Tyler3D/Big-Brane-AoE/Code/README.md

Arduino code stored in folder named "audio" to make sure INO files are concatenated in correct order (so that `main.ino` is imported last).
