Tyler3D/Big-Brane-AoE/Circuit/2020-12-13 - schematic.pdf

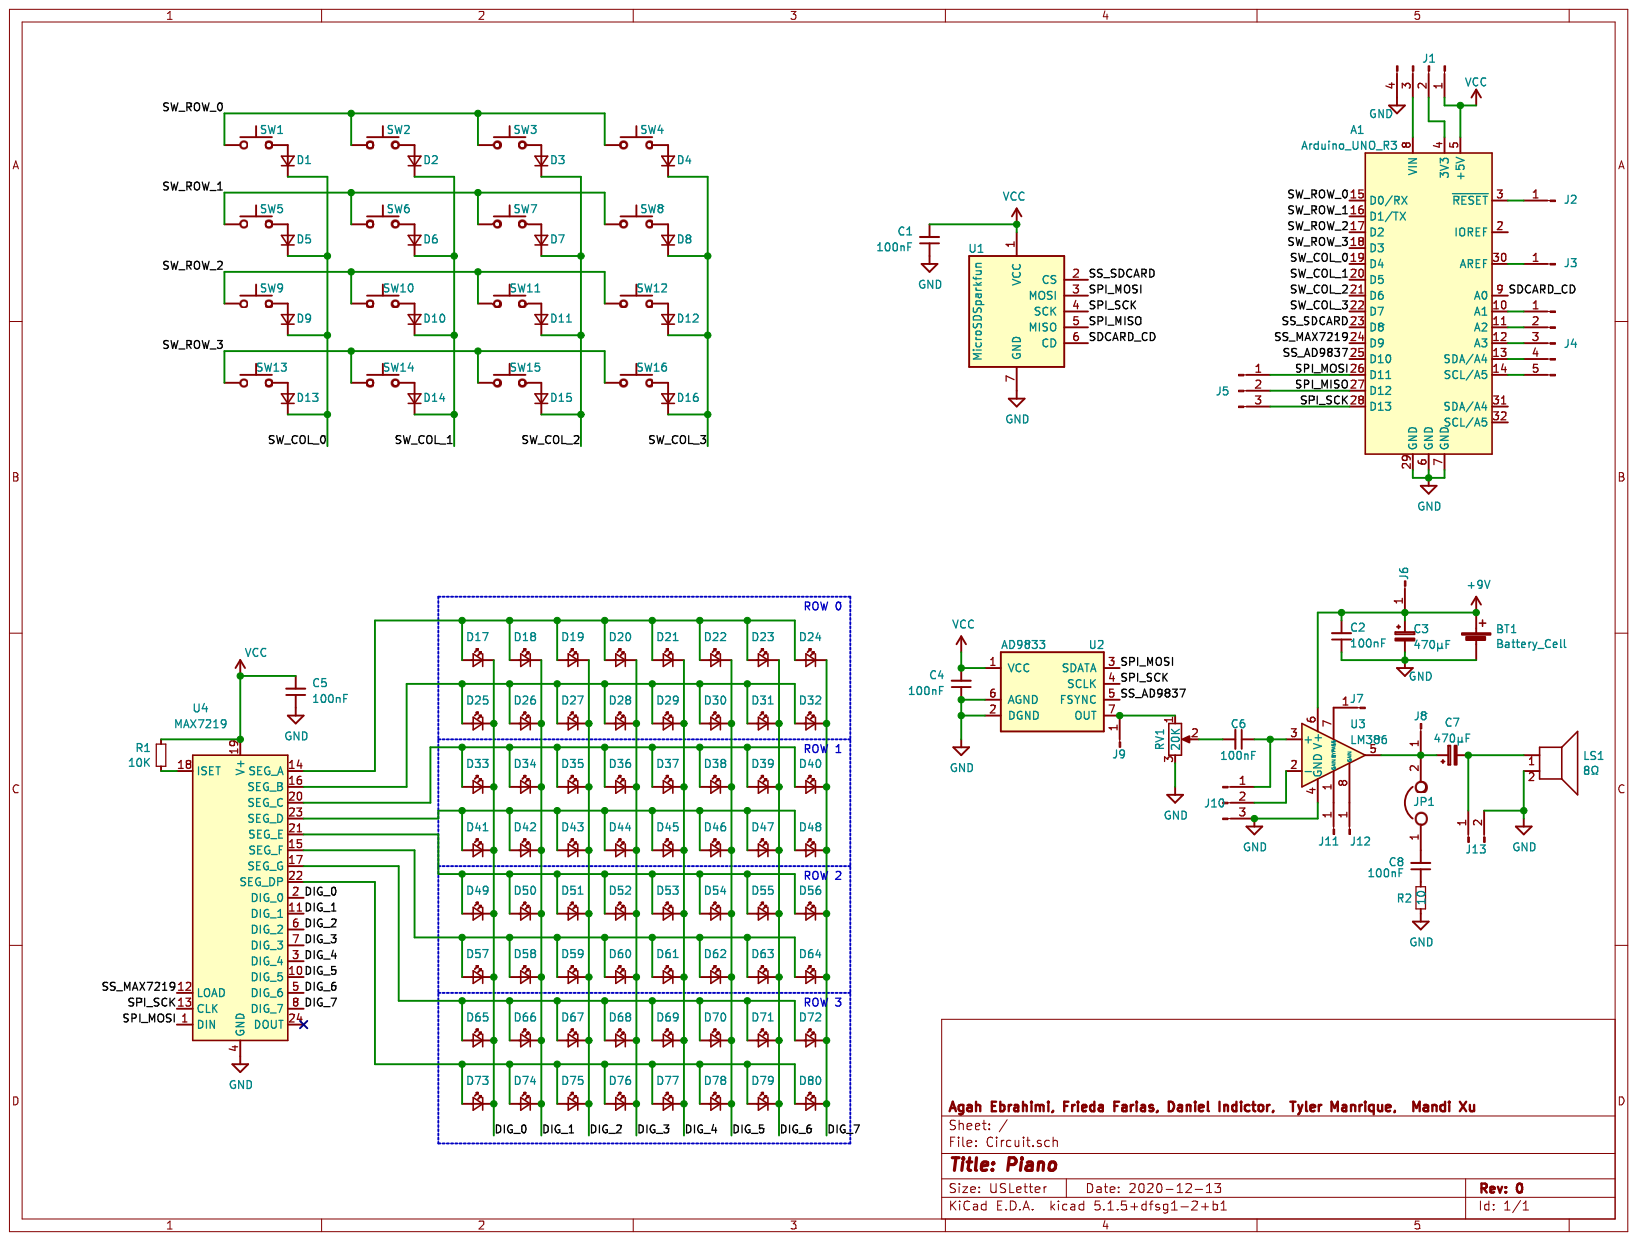
[picture p1: page 1]
