Tyler3D/Big-Brane-AoE/Circuit/Circuit.kicad_pcb

## KiCad design Circuit/Circuit.kicad_pcb (2020-12-20)

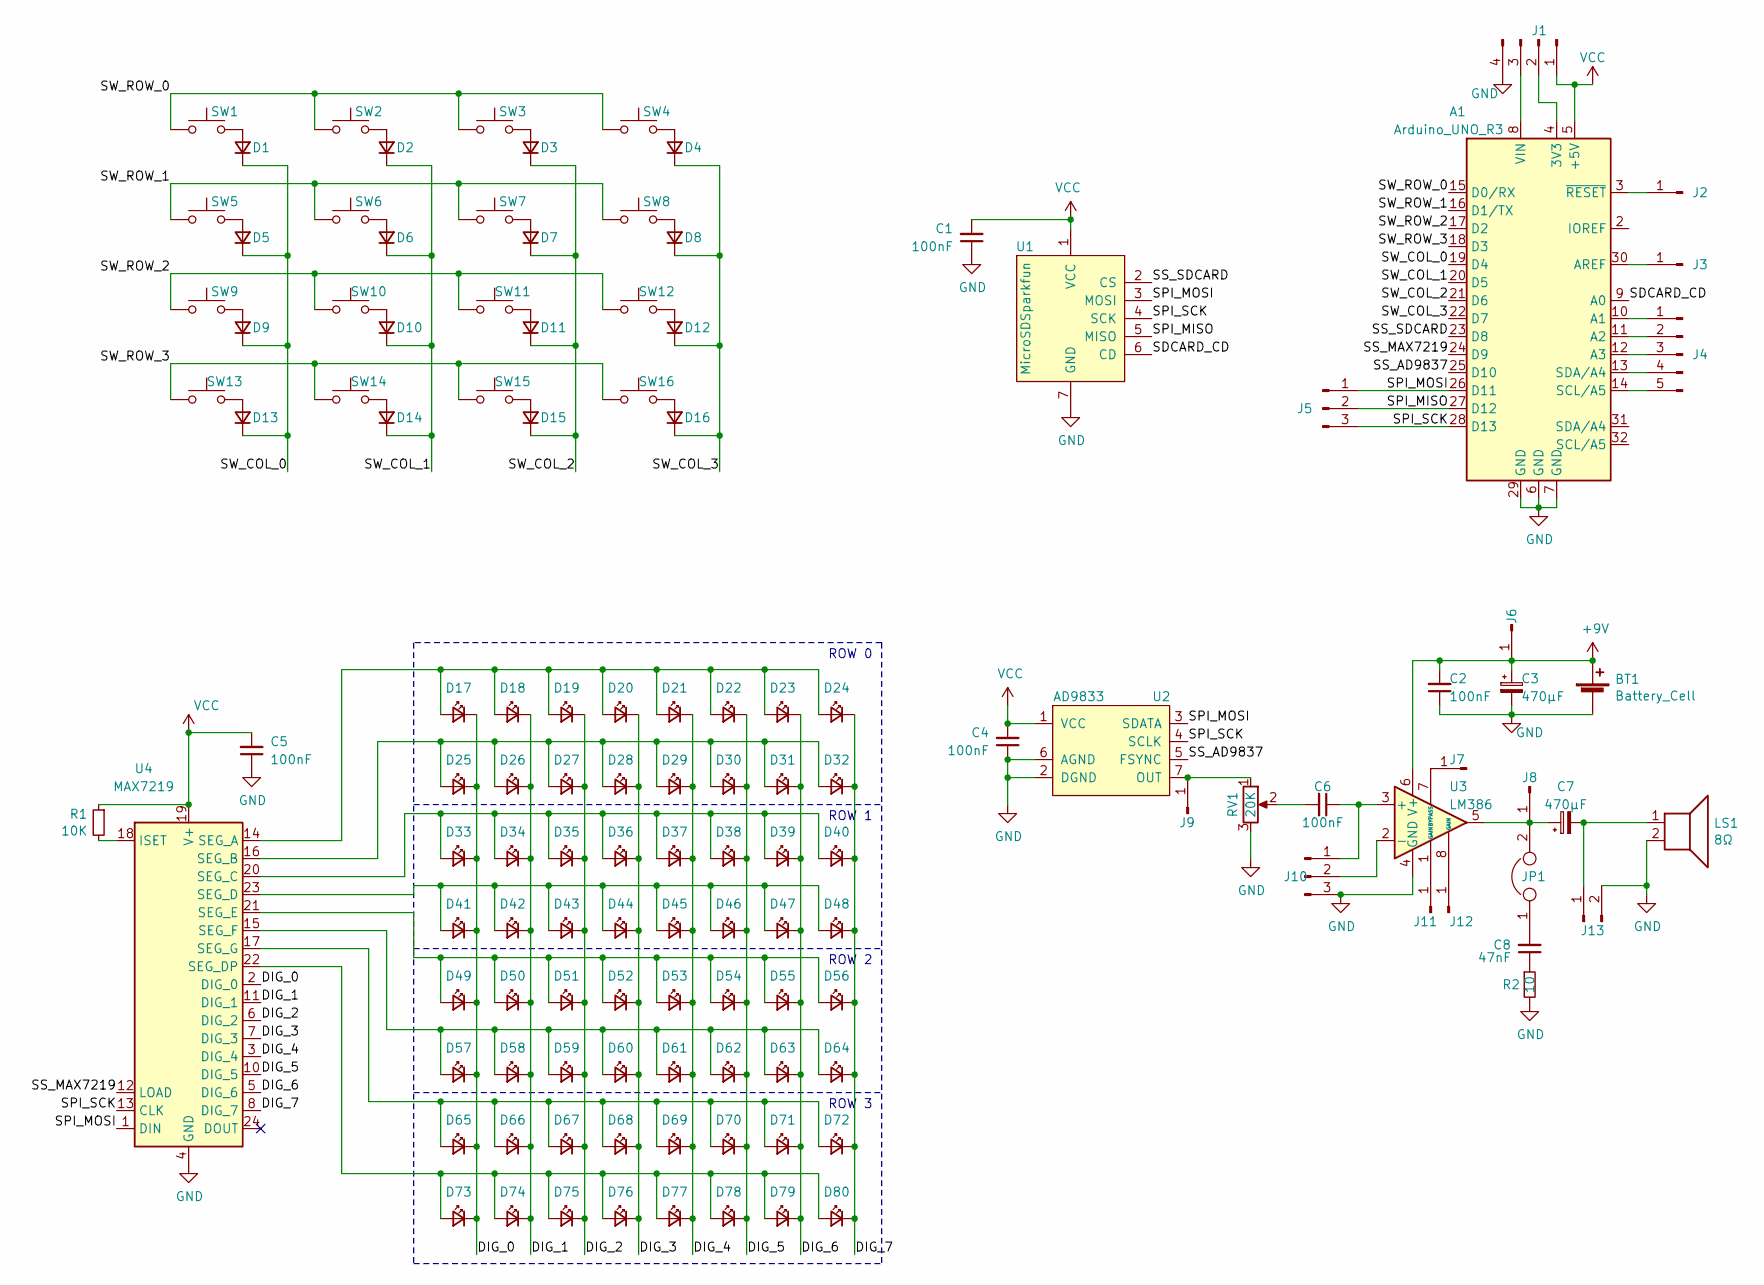
[picture p2: schematic Circuit.sch, Piano]

Parts:
A1: Arduino_UNO_R3
BT1: Battery_Cell; JST_EH_B2B-EH-A_1x02_P2.50mm_Vertical
C1, C2, C4, C5, C6: 100nF; C_Disc_D4.3mm_W1.9mm_P5.00mm
C3, C7: 470μF; CP_Radial_D14.0mm_P7.50mm
C8: 47nF; C_Disc_D4.3mm_W1.9mm_P5.00mm
D1, D2, D3, D4, D5, D6, D7, D8, D9, D10, D11, D12, D13, D14, D15, D16: D_Small; D_SMB_Handsoldering
D17, D18, D19, D20, D21, D22, D23, D24, D25, D26, D27, D28, D29, D30, D31, D32, D33, D34, D35, D36, D37, D38, D39, D40, D41, D42, D43, D44, D45, D46, D47, D48, D49, D50, D51, D52, D53, D54, D55, D56, D57, D58, D59, D60, D61, D62, D63, D64, D65, D66, D67, D68, D69, D70, D71, D72, D73, D74, D75, D76, D77, D78, D79, D80: LED_Small; LED_D3.0mm_FlatTop
J1: POWER; PinHeader_1x04_P2.54mm_Vertical
J2: RESET; PinHeader_1x01_P2.54mm_Vertical
J3: AREF; PinHeader_1x01_P2.54mm_Vertical
J4: Analog Breakout; PinHeader_1x05_P2.54mm_Vertical
J5: SPI (MOSI, MISO, SCK); PinHeader_1x03_P2.54mm_Vertical
J6: LM386 VCC; PinHeader_1x01_P2.54mm_Vertical
J7: BYPASS; PinHeader_1x01_P2.54mm_Vertical
J8: LM386 OUT; PinHeader_1x01_P2.54mm_Vertical
J9: AD9833 OUT; PinHeader_1x01_P2.54mm_Vertical
J10: LM386 IN; PinHeader_1x03_P2.54mm_Vertical
J11: GAIN 1; PinHeader_1x01_P2.54mm_Vertical
J12: GAIN 8; PinHeader_1x01_P2.54mm_Vertical
J13: SPKR; PinHeader_1x02_P2.54mm_Vertical
JP1: Jumper; PinHeader_1x02_P2.54mm_Vertical
LS1: 8Ω; JST_EH_B2B-EH-A_1x02_P2.50mm_Vertical
R1: 10K; R_Axial_DIN0207_L6.3mm_D2.5mm_P7.62mm_Horizontal
R2: 10; R_Axial_DIN0207_L6.3mm_D2.5mm_P7.62mm_Horizontal
RV1: 20K; Potentiometer_Vishay_148-149_Single_Horizontal
SW1, SW2, SW3, SW4, SW5, SW6, SW7, SW8, SW9, SW10, SW11, SW12, SW13, SW14, SW15, SW16: SW_Push; SW_Cherry_MX_1.00u_PCB
U1: MicroSDSparkfun; PinHeader_1x07_P2.54mm_Horizontal
U2: AD9833; PinHeader_1x07_P2.54mm_Vertical
U3: LM386; DIP-8_W7.62mm_Socket_LongPads
U4: MAX7219; DIP-24_W7.62mm_LongPads

Connections:
+9V: BT1.1 (+), C2.2, C3.1, J6.1, U3.6 (V+)
/DIG_0: D17.1 (K), D25.1 (K), D33.1 (K), D41.1 (K), D49.1 (K), D57.1 (K), D65.1 (K), D73.1 (K), U4.2 (DIG_0)
/DIG_1: D18.1 (K), D26.1 (K), D34.1 (K), D42.1 (K), D50.1 (K), D58.1 (K), D66.1 (K), D74.1 (K), U4.11 (DIG_1)
/DIG_2: D19.1 (K), D27.1 (K), D35.1 (K), D43.1 (K), D51.1 (K), D59.1 (K), D67.1 (K), D75.1 (K), U4.6 (DIG_2)
/DIG_3: D20.1 (K), D28.1 (K), D36.1 (K), D44.1 (K), D52.1 (K), D60.1 (K), D68.1 (K), D76.1 (K), U4.7 (DIG_3)
/DIG_4: D21.1 (K), D29.1 (K), D37.1 (K), D45.1 (K), D53.1 (K), D61.1 (K), D69.1 (K), D77.1 (K), U4.3 (DIG_4)
/DIG_5: D22.1 (K), D30.1 (K), D38.1 (K), D46.1 (K), D54.1 (K), D62.1 (K), D70.1 (K), D78.1 (K), U4.10 (DIG_5)
/DIG_6: D23.1 (K), D31.1 (K), D39.1 (K), D47.1 (K), D55.1 (K), D63.1 (K), D71.1 (K), D79.1 (K), U4.5 (DIG_6)
/DIG_7: D24.1 (K), D32.1 (K), D40.1 (K), D48.1 (K), D56.1 (K), D64.1 (K), D72.1 (K), D80.1 (K), U4.8 (DIG_7)
/SDCARD_CD: A1.9 (A0), U1.6 (CD)
/SPI_MISO: A1.27 (D12), J5.2, U1.5 (MISO)
/SPI_MOSI: A1.26 (D11), J5.1, U1.3 (MOSI), U2.3 (SDATA), U4.1 (DIN)
/SPI_SCK: A1.28 (D13), J5.3, U1.4 (SCK), U2.4 (SCLK), U4.13 (CLK)
/SS_AD9837: A1.25 (D10), U2.5 (FSYNC)
/SS_MAX7219: A1.24 (D9), U4.12 (LOAD)
/SS_SDCARD: A1.23 (D8), U1.2 (CS)
/SW_COL_0: A1.19 (D4), D1.1 (K), D5.1 (K), D9.1 (K), D13.1 (K)
/SW_COL_1: A1.20 (D5), D2.1 (K), D6.1 (K), D10.1 (K), D14.1 (K)
/SW_COL_2: A1.21 (D6), D3.1 (K), D7.1 (K), D11.1 (K), D15.1 (K)
/SW_COL_3: A1.22 (D7), D4.1 (K), D8.1 (K), D12.1 (K), D16.1 (K)
/SW_ROW_0: A1.15 (D0/RX), SW1.2, SW2.2, SW3.2, SW4.2
/SW_ROW_1: A1.16 (D1/TX), SW5.2, SW6.2, SW7.2, SW8.2
/SW_ROW_2: A1.17 (D2), SW9.2, SW10.2, SW11.2, SW12.2
/SW_ROW_3: A1.18 (D3), SW13.2, SW14.2, SW15.2, SW16.2
GND: A1.6 (GND), A1.7 (GND), A1.29 (GND), BT1.2 (-), C1.1, C2.1, C3.2, C4.1, C5.1, J1.4, J10.3, J13.2, LS1.2, R2.2, RV1.3, U1.7 (GND), U2.2 (DGND), U2.6 (AGND), U3.4 (GND), U4.4 (GND), U4.9 (GND)
unnamed: A1.3 (~RESET), J2.1
unnamed: A1.4 (3V3), J1.2
unnamed: A1.8 (VIN), J1.3
unnamed: A1.10 (A1), J4.1
unnamed: A1.11 (A2), J4.2
unnamed: A1.12 (A3), J4.3
unnamed: A1.13 (SDA/A4), J4.4
unnamed: A1.14 (SCL/A5), J4.5
unnamed: A1.30 (AREF), J3.1
unnamed: C6.1, J10.1, U3.3 (+)
unnamed: C6.2, RV1.2
unnamed: C7.1, J8.1, JP1.2, U3.5
unnamed: C7.2, J13.1, LS1.1
unnamed: C8.1, R2.1
unnamed: C8.2, JP1.1
unnamed: D1.2 (A), SW1.1
unnamed: D2.2 (A), SW2.1
unnamed: D3.2 (A), SW3.1
unnamed: D4.2 (A), SW4.1
unnamed: D5.2 (A), SW5.1
unnamed: D6.2 (A), SW6.1
unnamed: D7.2 (A), SW7.1
unnamed: D8.2 (A), SW8.1
unnamed: D9.2 (A), SW9.1
unnamed: D10.2 (A), SW10.1
unnamed: D11.2 (A), SW11.1
unnamed: D12.2 (A), SW12.1
unnamed: D13.2 (A), SW13.1
unnamed: D14.2 (A), SW14.1
unnamed: D15.2 (A), SW15.1
unnamed: D16.2 (A), SW16.1
unnamed: D17.2 (A), D18.2 (A), D19.2 (A), D20.2 (A), D21.2 (A), D22.2 (A), D23.2 (A), D24.2 (A), U4.14 (SEG_A)
unnamed: D25.2 (A), D26.2 (A), D27.2 (A), D28.2 (A), D29.2 (A), D30.2 (A), D31.2 (A), D32.2 (A), U4.16 (SEG_B)
unnamed: D33.2 (A), D34.2 (A), D35.2 (A), D36.2 (A), D37.2 (A), D38.2 (A), D39.2 (A), D40.2 (A), U4.20 (SEG_C)
unnamed: D41.2 (A), D42.2 (A), D43.2 (A), D44.2 (A), D45.2 (A), D46.2 (A), D47.2 (A), D48.2 (A), U4.23 (SEG_D)
unnamed: D49.2 (A), D50.2 (A), D51.2 (A), D52.2 (A), D53.2 (A), D54.2 (A), D55.2 (A), D56.2 (A), U4.21 (SEG_E)
unnamed: D57.2 (A), D58.2 (A), D59.2 (A), D60.2 (A), D61.2 (A), D62.2 (A), D63.2 (A), D64.2 (A), U4.15 (SEG_F)
unnamed: D65.2 (A), D66.2 (A), D67.2 (A), D68.2 (A), D69.2 (A), D70.2 (A), D71.2 (A), D72.2 (A), U4.17 (SEG_G)
unnamed: D73.2 (A), D74.2 (A), D75.2 (A), D76.2 (A), D77.2 (A), D78.2 (A), D79.2 (A), D80.2 (A), U4.22 (SEG_DP)
unnamed: J7.1, U3.7 (BYPASS)
unnamed: J9.1, RV1.1, U2.7 (OUT)
unnamed: J10.2, U3.2 (-)
unnamed: J11.1, U3.1 (GAIN)
unnamed: J12.1, U3.8 (GAIN)
unnamed: R1.2, U4.18 (ISET)
VCC: A1.5 (+5V), C1.2, C4.2, C5.2, J1.1, R1.1, U1.1 (VCC), U2.1 (VCC), U4.19 (V+)

Notes on the sheet:
ROW 0
ROW 1
ROW 2
ROW 3

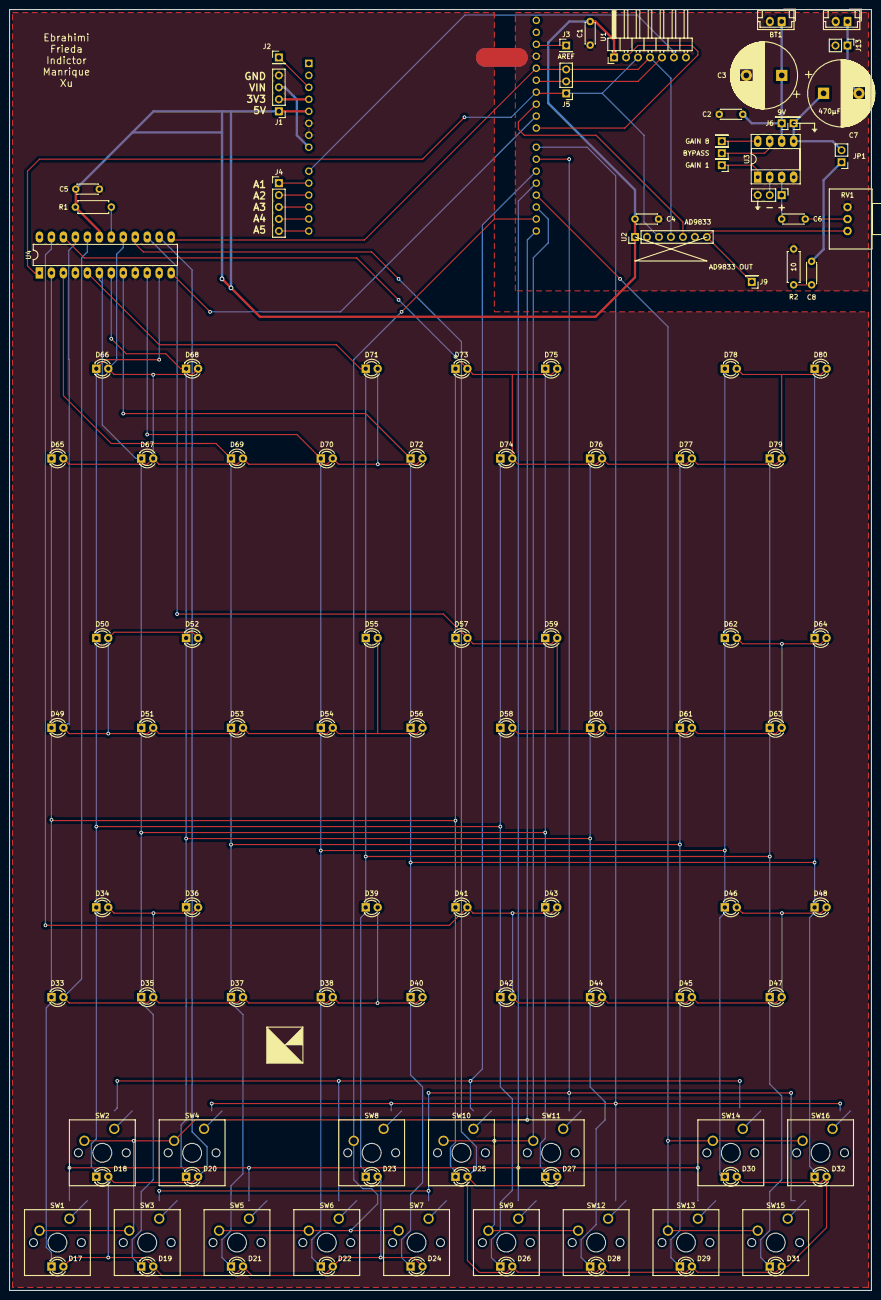
[picture p3: board Circuit.kicad_pcb from above]

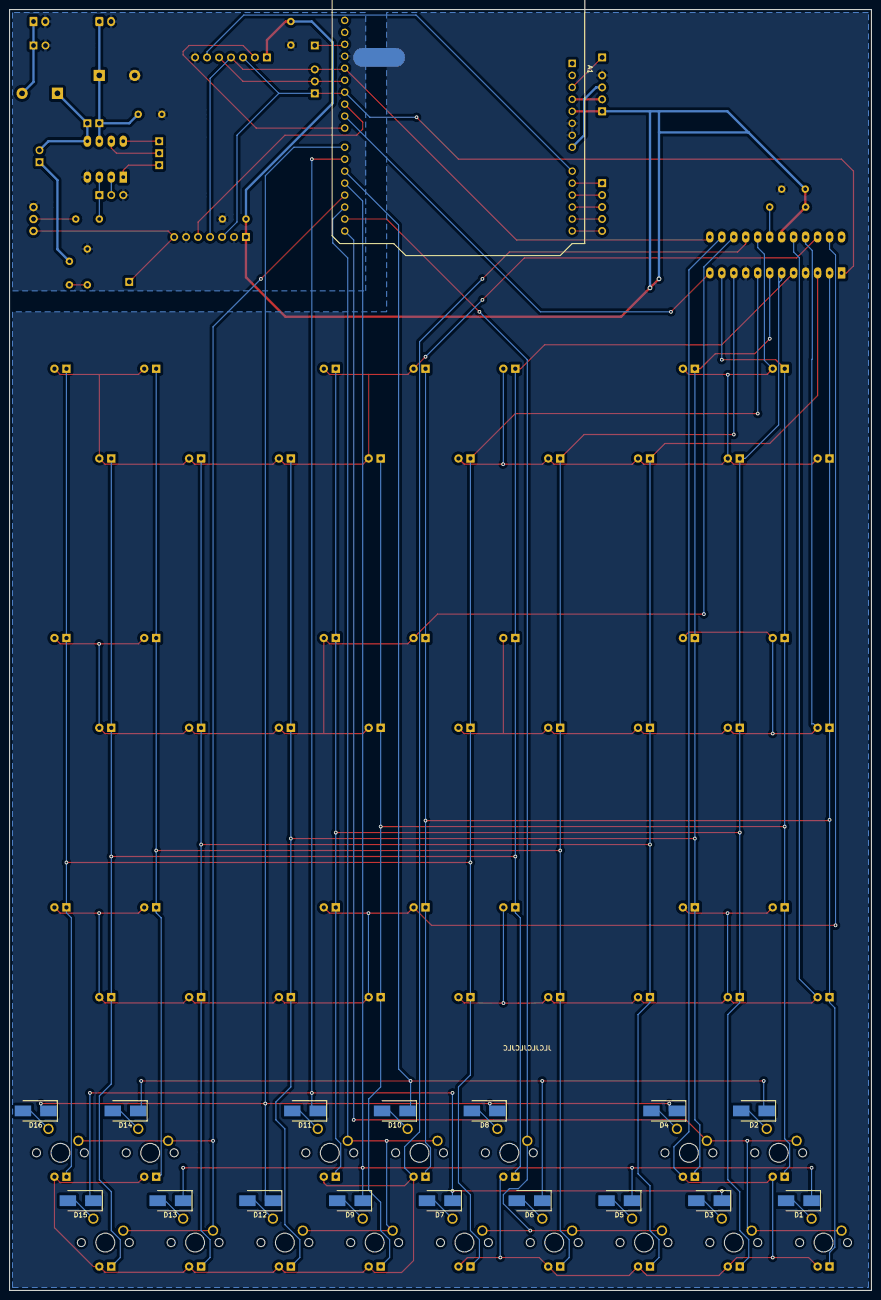
[picture p4: board Circuit.kicad_pcb from below]

Board: 2 copper layers, 182.9 x 271.8 mm, 128 parts (17 on the bottom side), 71 nets.
