Tyler3D/Big-Brane-AoE/(commit log)

2020-11-10 Started circuit schematic design. Finished button and LED Matrices.
    [Circuit.kicad_pcb, Circuit.sch]
2020-11-14 Add tones
    [tones.ods]
2020-11-26 Make progress with audio and start laying out PCB.
    [Circuit.sch]
2020-12-03 Added more traces, added all footprints, and made minor corrections to schematic.
    [Circuit.kicad_pcb, Circuit.sch]
2020-12-03 Fixed tones.
    [tones.csv, tones.ods]
2020-12-09 Adding schematic for all to see.
2020-12-13 Added button, LED, and audio code.
2020-12-13 Add Gerbers.
    [Circuit-B_Cu.gbr, Circuit-B_Mask.gbr, Circuit-B_SilkS.gbr, Circuit-Edge_Cuts.gbr, Circuit-F_Cu.gbr, Circuit-F_Mask.gbr, Circuit-F_SilkS.gbr, Circuit.drl]
2020-12-13 Upload final version of Schematic and board layout.
    [Circuit.kicad_pcb, Circuit.sch]
2020-12-20 Final touches on circuit.
    [Circuit.kicad_pcb, Circuit.sch]
